opensimgear/device-gateway/electronics/boards/gateway/0.1.0/FOOTPRINTS.md

# Gateway footprint review

The local libraries travel with the KiCad project. Footprints are reviewed against drawings, not inferred from connector nicknames. Exact purchased samples and a fabricator slot/hole review are still required before ordering.

| Ref / part | Geometry and numbering checked | Source |
| --- | --- | --- |
| J2/J3 Evercom 5301-4P4C | Four actual contact positions; component-side drawing gives 1=(0,0), 2=(1.27,−2.54), 3=(2.54,0), 4=(3.81,−2.54) mm. Four Ø0.90 mm plated holes. Pegs (−1.91,6.35) and (5.59,6.35) mm, Ø3.20 mm unplated, 7.50 mm pitch. Body 11.10 ×18.05 ×11.45 mm; nose +Y14.25, rear −Y3.80. | Evercom 5301-440XXX Rev A, 2025-09-23, obtained from [C3097715](https://jlcpcb.com/partdetail/EVERCOM-53014P4C/C3097715); preserved at `.research/gateway-datasheets/evercom-5301.pdf`. |
| J5 Same Sky PJ-102AH | Pin 1 center positive at (0,0), pin 2 sleeve at (0,6), pin 3 switched sleeve at (4.7,3) mm; pin 3 intentionally NC. Current drawing calls for 1.0 ×1.6 mm slots; the local footprint uses 1.2 ×1.8 mm plated slots with allowance, oriented along X for pins 1/2 and Y for pin 3. Body/positions derive from the stock PJ-102AH footprint. Nose +Y13.7 mm. | [Manufacturer drawing](https://www.sameskydevices.com/product/resource/pj-102ah.pdf), 2024-09-12; `.research/gateway-datasheets/pj-102ah.pdf`. |
| F1 / F2 Littelfuse 1206L020/30YR / 1206L035/30WR | Manufacturer 1206L land pattern: two 1.8 ×1.8 mm lands with 1.0 mm gap. Both are 30 V rated. F1 0.20 A hold /0.42 A trip; F2 0.35 A hold /0.75 A trip, ratings at 20°C. | [Current 1206L data sheet](https://www.littelfuse.com/assetdocs/littelfuse-ptc-1206l-datasheet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); table extract at `.research/gateway-datasheets/littelfuse-1206l-excerpt.md`. |
| D6 SS14 / D7 SMBJ15A | Stock SMA / SMB lands; cathode pin 1, anode pin 2. D6 cathode is BUS_12V; D7 cathode BUS_12V, anode GND. | [SS14](https://www.vishay.com/docs/88746/ss12.pdf), [SMBJ](https://www.vishay.com/docs/88392/smbj.pdf). |
| U1, J1, U3, U4–U7 | Retained reviewed starter MCU, USB-C, SOIC transceiver, RECOM converter, LDO and manufacturer DCK0006A LM66100 geometry. Board USB routing retains the original stackup/width/gap. | MPN and manufacturer links in [BOM](bom.csv); local KiCad/OpenSimGear libraries. |

The native 4P4C footprint is `OpenSimGear.pretty/RJ4P4C_Evercom_5301-4P4C_Horizontal.kicad_mod`. Its pad numbers come from the component-side primary drawing; do not reverse them using a plug-view sketch. On this PCB both sockets rotate 90° clockwise in KiCad, with mouths facing the east edge. Actual board pad numbers remain 1 BUS_12V, 2 CAN_H, 3 CAN_L, 4 GND. Review the numbered native pads or a 1:1 plot when defining a cable tester.

To migrate another board, run `python3 tools/install-4p4c-footprint.py /absolute/path/to/its/revision` from the repository root to copy this footprint into its project-local OpenSimGear library, replace the socket symbol with four pins, explicitly reconnect all four net assignments, then update PCB placement and routing. A six-contact footprint cannot safely be changed by deleting its outer contacts: body, locating holes, stagger, pitch, numbering and electrical assignment differ. Regenerate the netlist, run schematic parity/ERC/DRC, and requalify purchased plugs and straight-through cable continuity. The separate module migration is outside this gateway revision.

The upstream footprint library license is retained in [LICENSE-KICAD.md](LICENSE-KICAD.md). The Evercom footprint is derived from KiCad's `RJ9_Evercom_5301-440xxx_Horizontal`, with the current 18.05 mm body depth, local MPN/description, reference on F.Fab and no unverified 3D model. Other unused copied library entries are not part of the BOM.
