opensimgear/device-gateway/electronics/boards/gateway/0.1.0/fabrication/drill/drill-report.txt

Drill report for gateway.kicad_pcb
Created on 2026-10-13T10:36:43

Copper Layer Stackup:
    =============================================================
    L1 :  F.Cu                      front
    L2 :  In1.Cu                    in1
    L3 :  In2.Cu                    in2
    L4 :  B.Cu                      back

Drill file 'gateway-PTH.drl' contains
    plated through holes:
    =============================================================
    T1  0.300mm  0.0118"  (93 holes))
    T2  0.600mm  0.0236"  (4 holes)  (with 4 slots)
    T3  0.900mm  0.0354"  (8 holes))
    T4  1.000mm  0.0394"  (3 holes))
    T5  1.020mm  0.0402"  (8 holes))
    T6  1.100mm  0.0433"  (4 holes))
    T7  1.200mm  0.0472"  (3 holes)  (with 3 slots)

    Total plated holes count 123

Drill file 'gateway-NPTH.drl' contains
    unplated through holes:
    =============================================================
    T1  0.650mm  0.0256"  (2 holes))
    T2  3.200mm  0.1260"  (8 holes))

    Total unplated holes count 10
