opensimgear/device-gateway/THIRD_PARTY_NOTICES.md

# Third-party materials

The repository's [all-rights-reserved notice](LICENSE) applies to original
OpenSimGear material. It does not relicense dependencies, third-party assets,
upstream library data or other separately licensed portions.

## Existing notices and provenance

- [Firmware notices](firmware/THIRD_PARTY.md) retain the TinyUSB, STM32 HAL,
  STM32 CMSIS and Arm CMSIS notices and dependency provenance.
- [libcanard](firmware/shared-cyphal/vendor/libcanard/LICENSE),
  [regulated DSDL](firmware/shared-cyphal/vendor/REGULATED_DSDL_LICENSE) and
  [Nunavut support](firmware/shared-cyphal/generated/NUNAVUT_LICENSE.rst)
  retain their upstream terms.
- [Included KiCad library data](electronics/boards/gateway/0.1.0/LICENSE-KICAD.md)
  retains the KiCad library license and exception, including where applicable
  to derived library entries.
- The Pico simulation uses separately licensed Pico SDK and TinyUSB sources;
  their notices remain with those sources and packaged firmware.

This file is a scope and provenance index, not a replacement for the full license
texts and copyright notices accompanying third-party material. Preserve the
applicable full notices when redistributing or packaging those portions. Existing
upstream permissions, including any commercial permissions, remain unaffected.
