opensimgear/device-gateway/electronics/boards/gateway/0.1.0/review/pcb.png

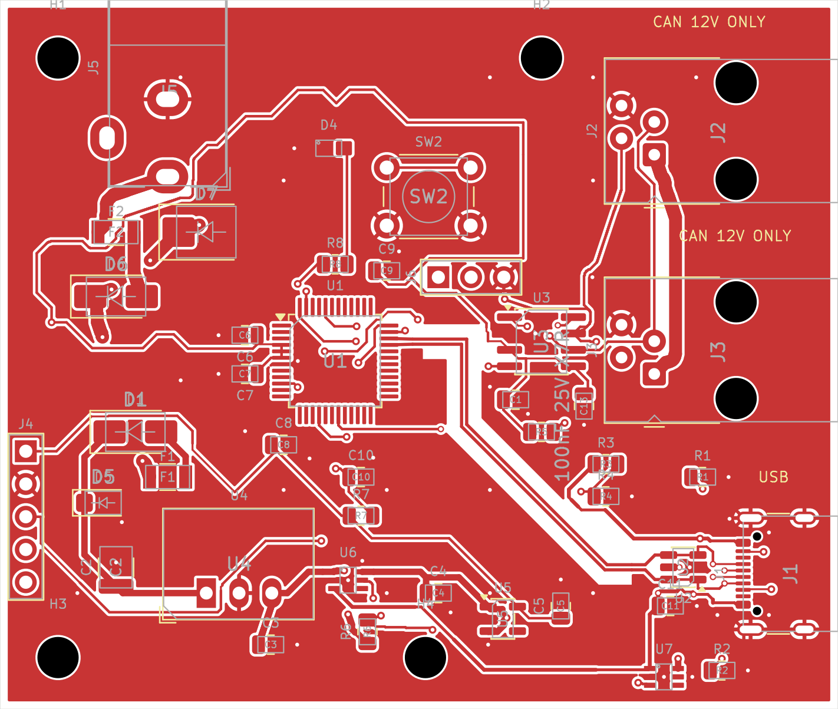
electronics/boards/gateway/0.1.0/review/pcb.png
