opensimgear/device-gateway/electronics/boards/gateway/0.1.0/bom.csv

Reference | Value | Manufacturer part | Footprint | Datasheet
C1 | 100nF 25V X7R | C0805C104K3RACTU | KiCad:C_0805_2012Metric | https://content.kemet.com/datasheets/KEM_C1002_X7R_SMD.pdf
C2 | 10uF 50V X7R | GRM32ER71H106KA12L | KiCad:C_1210_3225Metric | https://search.murata.co.jp/Ceramy/image/img/A01X/G101/ENG/GRM32ER71H106KA12-04A.pdf
C3 | 1uF 25V X7R | C2012X7R1E105K125AB | KiCad:C_0805_2012Metric | https://product.tdk.com/en/search/capacitor/ceramic/mlcc/info?part_no=C2012X7R1E105K125AB
C4 | 1uF 25V X7R | C2012X7R1E105K125AB | KiCad:C_0805_2012Metric | https://product.tdk.com/en/search/capacitor/ceramic/mlcc/info?part_no=C2012X7R1E105K125AB
C5 | 2.2uF 25V X7R | C2012X7R1E225K125AB | KiCad:C_0805_2012Metric | https://product.tdk.com/en/search/capacitor/ceramic/mlcc/info?part_no=C2012X7R1E225K125AB
C6 | 100nF 25V X7R | C0805C104K3RACTU | KiCad:C_0805_2012Metric | https://content.kemet.com/datasheets/KEM_C1002_X7R_SMD.pdf
C7 | 1uF 25V X7R | C2012X7R1E105K125AB | KiCad:C_0805_2012Metric | https://product.tdk.com/en/search/capacitor/ceramic/mlcc/info?part_no=C2012X7R1E105K125AB
C8 | 100nF 25V X7R | C0805C104K3RACTU | KiCad:C_0805_2012Metric | https://content.kemet.com/datasheets/KEM_C1002_X7R_SMD.pdf
C9 | 100nF 25V X7R | C0805C104K3RACTU | KiCad:C_0805_2012Metric | https://content.kemet.com/datasheets/KEM_C1002_X7R_SMD.pdf
C10 | 100nF 25V X7R | C0805C104K3RACTU | KiCad:C_0805_2012Metric | https://content.kemet.com/datasheets/KEM_C1002_X7R_SMD.pdf
C11 | 100nF 25V X7R | C0805C104K3RACTU | KiCad:C_0805_2012Metric | https://content.kemet.com/datasheets/KEM_C1002_X7R_SMD.pdf
C13 | 100nF 25V X7R | C0805C104K3RACTU | KiCad:C_0805_2012Metric | https://content.kemet.com/datasheets/KEM_C1002_X7R_SMD.pdf
D1 | SS14 | SS14-E3/61T | KiCad:D_SMA | https://www.vishay.com/docs/88746/ss12.pdf
D4 | GREEN | AP2012SGC | OpenSimGear:LED_Kingbright_AP2012SGC_0805 | https://www.kingbrightusa.com/images/catalog/SPEC/AP2012SGC.pdf
D5 | SMF15A-E3-08 | SMF15A-E3-08 | KiCad:D_SMF | https://www.vishay.com/docs/85881/smf5v0atosmf58a.pdf
D6 | SS14 | SS14-E3/61T | KiCad:D_SMA | https://www.vishay.com/docs/88746/ss12.pdf
D7 | SMBJ15A-E3/52 | SMBJ15A-E3/52 | KiCad:D_SMB | https://www.vishay.com/docs/88392/smbj.pdf
F1 | 0.20A hold / 30V | 1206L020/30YR | OpenSimGear:Fuse_Littelfuse_1206L020-30YR | https://www.littelfuse.com/assetdocs/littelfuse-ptc-1206l-datasheet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
F2 | 0.35A hold / 30V | 1206L035/30WR | OpenSimGear:Fuse_Littelfuse_1206L035-30WR | https://www.littelfuse.com/assetdocs/littelfuse-ptc-1206l-datasheet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
H1 | M3 3.2mm |  | KiCad:MountingHole_3.2mm_M3
H2 | M3 3.2mm |  | KiCad:MountingHole_3.2mm_M3
H3 | M3 3.2mm |  | KiCad:MountingHole_3.2mm_M3
H4 | M3 3.2mm |  | KiCad:MountingHole_3.2mm_M3
J1 | USB-C DEVICE | USB4105-GF-A | KiCad:USB_C_Receptacle_GCT_USB4105-xx-A_16P_TopMnt_Horizontal | https://gct.co/files/drawings/usb4105.pdf
J2 | 4P4C POWERED CAN | 5301-4P4C | OpenSimGear:RJ4P4C_Evercom_5301-4P4C_Horizontal | https://jlcpcb.com/partdetail/EVERCOM-53014P4C/C3097715
J3 | 4P4C POWERED CAN | 5301-4P4C | OpenSimGear:RJ4P4C_Evercom_5301-4P4C_Horizontal | https://jlcpcb.com/partdetail/EVERCOM-53014P4C/C3097715
J4 | SWD / 3V3 REFERENCE ONLY | TSW-105-07-L-S | OpenSimGear:PinHeader_Samtec_TSW-105-07-L-S_P2.54mm_Vertical | https://suddendocs.samtec.com/prints/tsw-xxx-xx-x-x-xx-xxx-footprint.pdf
J5 | 12V DC CENTER + / 5.5x2.1 | PJ-102AH | OpenSimGear:BarrelJack_SameSky_PJ-102AH_Horizontal | https://www.sameskydevices.com/product/resource/pj-102ah.pdf
J6 | CAN TEST / END TERMINATION | TSW-103-07-L-S | OpenSimGear:PinHeader_Samtec_TSW-103-07-L-S_P2.54mm_Vertical | https://suddendocs.samtec.com/prints/tsw-xxx-xx-x-x-xx-xxx-footprint.pdf
R1 | 5.1k 1% | RC0805FR-075K1L | KiCad:R_0805_2012Metric | https://www.yageogroup.com/component-documentation/download/specsheet/RC0805FR-075K1L
R2 | 5.1k 1% | RC0805FR-075K1L | KiCad:R_0805_2012Metric | https://www.yageogroup.com/component-documentation/download/specsheet/RC0805FR-075K1L
R3 | 10k 1% | RC0805FR-0710KL | KiCad:R_0805_2012Metric | https://www.yageogroup.com/component-documentation/download/specsheet/RC0805FR-0710KL
R4 | 15k 1% | RC0805FR-0715KL | KiCad:R_0805_2012Metric | https://www.yageogroup.com/component-documentation/download/specsheet/RC0805FR-0715KL
R5 | 10k | RC0805FR-0710KL | KiCad:R_0805_2012Metric | https://www.yageogroup.com/component-documentation/download/specsheet/RC0805FR-0710KL
R6 | 10k | RC0805FR-0710KL | KiCad:R_0805_2012Metric | https://www.yageo.com/upload/media/product/productsearch/datasheet/rchip/PYu-RC_Group_51_RoHS_L_13.pdf
R7 | 10k | RC0805FR-0710KL | KiCad:R_0805_2012Metric | https://www.yageogroup.com/component-documentation/download/specsheet/RC0805FR-0710KL
R8 | 1k | RC0805FR-071KL | KiCad:R_0805_2012Metric | https://www.yageogroup.com/component-documentation/download/specsheet/RC0805FR-071KL
SW2 | RESET | B3F-1002-G | KiCad:SW_PUSH_6mm_H4.3mm | https://omronfs.omron.com/en_US/ecb/products/pdf/en-b3f.pdf
U1 | STM32G0B1CBT6 | STM32G0B1CBT6 | KiCad:LQFP-48_7x7mm_P0.5mm | https://www.st.com/resource/en/datasheet/stm32g0b1cb.pdf
U2 | USBLC6-2SC6 | USBLC6-2SC6 | KiCad:SOT-23-6 | https://www.st.com/resource/en/datasheet/usblc6-2.pdf
U3 | TCAN3413D | TCAN3413D | KiCad:SOIC-8_3.9x4.9mm_P1.27mm | https://www.ti.com/lit/ds/symlink/tcan3413.pdf
U4 | R-78E5.0-0.5 | R-78E5.0-0.5 | KiCad:Converter_DCDC_RECOM_R-78E-0.5_THT | https://recom-power.com/pdf/Innoline/R-78E-0.5.pdf
U5 | TLV75533PDBVR | TLV75533PDBVR | KiCad:SOT-23-5 | https://www.ti.com/lit/ds/symlink/tlv755p.pdf
U6 | LM66100DCKR | LM66100DCKR | OpenSimGear:TI_DCK0006A_SC70-6_LM66100 | https://www.ti.com/lit/ds/symlink/lm66100.pdf
U7 | LM66100DCKR | LM66100DCKR | OpenSimGear:TI_DCK0006A_SC70-6_LM66100 | https://www.ti.com/lit/ds/symlink/lm66100.pdf
