opensimgear/device-gateway/tests/e2e/README.md

# Repository-owned end-to-end tests

## Development status and disclaimer

This project is heavily under development and is not ready for use. Use it entirely at your own risk. To the fullest extent permitted by applicable law, the authors and contributors disclaim all liability for any damage, loss, or other issues arising from its use.

See [the acceptance record](VERIFICATION.md) for the completed integration run.

Run from the repository root with Python 3.10+, Git and a C11 compiler:

```sh
python3 tests/e2e/run.py --sanitize
```

To clone and build Cockpit too (requires Node.js, pnpm and Rust/Tauri prerequisites):

```sh
python3 tests/e2e/run.py --sanitize --with-cockpit
```

The initiating repository owns the runner. It clones remote repositories listed in
`dependencies.json` into its ignored `.e2e/deps/`, initializes submodules recursively,
checks that both firmware repositories declare the same firmware-common commit,
and builds each runtime through that repository’s `simulation/build.py`.
The exact common pin is cloned automatically. Firmware refs are immutable commits
from the same contract milestone; update the device ref and both common pins
together so bootstrap cannot combine M3 firmware with M4 ownership callbacks. No parent setup or adjacent checkout
is consulted. Checkouts, builds, state and reports all stay under `.e2e/`.

`--prepare-only` provisions components without starting processes. The resulting
`.e2e/launch.json` names the binaries and owning source trees; `.e2e/resolved-dependencies.json`
records repository commits and any local working-tree snapshot hashes. Test evidence
is stored under `.e2e/runs/`. Remote application refs are intentionally `main` while
the project is work in progress; the resolved manifest records what a run actually used.

For unpublished cross-repository development, pass explicit source overrides:

```sh
python3 tests/e2e/run.py --sanitize --with-cockpit \
  --source device-template=/absolute/path/to/device-template \
  --source cockpit=/absolute/path/to/cockpit
```

An override still creates an isolated Git clone, applies the source’s tracked diff
and nonignored new files, and initializes its dependencies. It never modifies or
builds inside the source checkout. Clean submodule commit changes are initialized
after the snapshot is applied; uncommitted nested submodule contents are rejected
with a clear error. `.e2e/`, `.simulation/`, build outputs and other
ignored files are not copied. This is how coordinated changes can be tested before
they are published; default remote runs require those changes to exist on the
configured remote refs. A pinned firmware-common override uses the exact declared
commit, without local changes.

Only checkouts with a bootstrap receipt are replaced when sources change. Delete
this repository’s `.e2e/` to force clean provisioning. Run one bootstrap per repository
at a time. Bootstrap retry, executable-mode and submodule behavior can be checked
without network access using `python3 -m unittest discover -s tests/e2e -p 'test_*.py'`.

Each gateway acceptance run sets a fresh `OSG_SIMULATION_NAMESPACE` for its child
processes and records it in `result.json`. CDC discovery uses the corresponding
private `/tmp/opensimgear-<uid>/gateways-<name>/` directory, so an already running
desktop Cockpit cannot take the test gateway's single CDC connection after USB
layout detach/reconnect. The default simulator discovery path remains available
for ordinary development. Namespace/path bounds have separate native-runner tests.

The gateway scenario exercises three independent JSON devices, then a radio-panel process, through
real CDC and CAN transports, including device-before-gateway startup, profile changes,
saved configuration, automatic append and offline ghosts, generated HID layouts,
live and neutral reports, persistent Disable/Enable, offline Forget/rediscovery,
CDC-only empty state, save failure and restart recovery. Event checks capture a short press/release between polls, compare immutable retries with fresh pages, reject stale streams/boots and verify direct USB/disabled access without configuration or reconnect side effects. With `--with-cockpit`, the cloned Cockpit scenario also verifies its normal
discovery and configuration adapters against the gateway’s own build.

Native simulations execute the production configuration, flash journal, Cyphal
transport, registry and descriptor code. Loopback TCP carries CDC bytes and UDP
carries CAN frames. These tests validate protocol/report behavior; native streams
do not enumerate OS USB/HID devices. Physical USB/CAN acceptance remains separate.
