opensimgear/device-gateway/electronics/boards/gateway/0.1.0/review/schematic.pdf

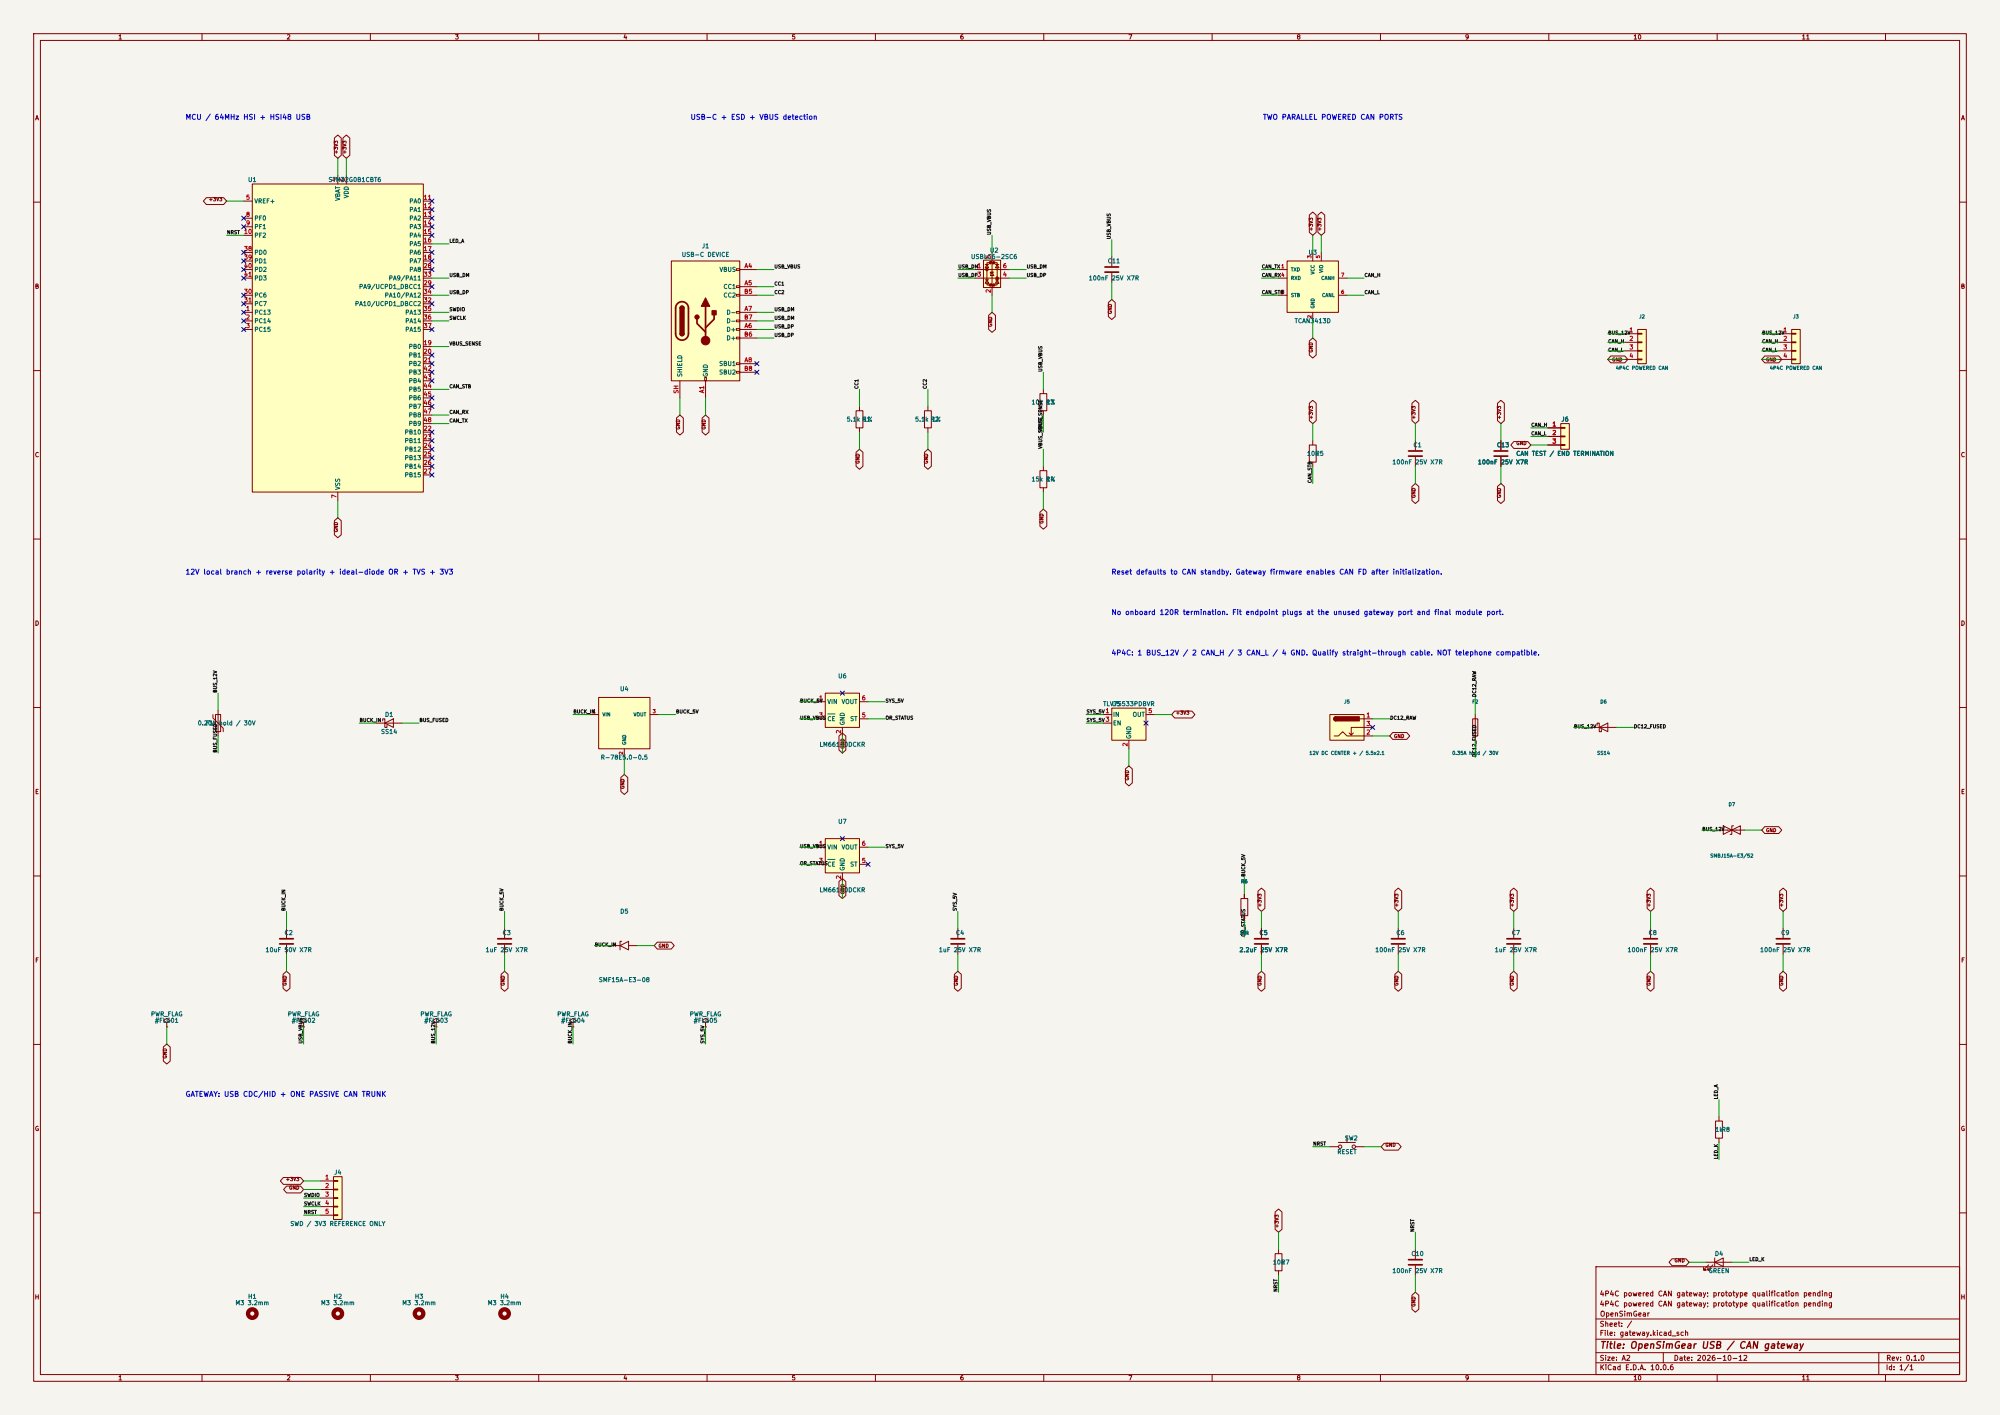
[picture p2: page 1]

4P4C powered CAN gateway; prototype qualification pending GND A1

J6 CAN TEST / END TERMINATION

12V local branch + reverse polarity + ideal-diode OR + TVS + 3V3

Reset defaults to CAN standby. Gateway firmware enables CAN FD after initialization.

No onboard 120R termination. Fit endpoint plugs at the unused gateway port and final module port.

4P4C: 1 BUS_12V / 2 CAN_H / 3 CAN_L / 4 GND. Qualify straight-through cable. NOT telephone compatible.

GATEWAY: USB CDC/HID + ONE PASSIVE CAN TRUNK

4P4C powered CAN gateway; prototype qualification pending
OpenSimGear
Sheet: /
File: gateway.kicad_sch
Title: OpenSimGear USB / CAN gateway

Size: A2 | Rev: 0.1.0
KiCad E.D.A. 10.0.6 | Id: 1/1
