opensimgear/device-gateway/electronics/boards/gateway/0.1.0/review/assembly.pdf

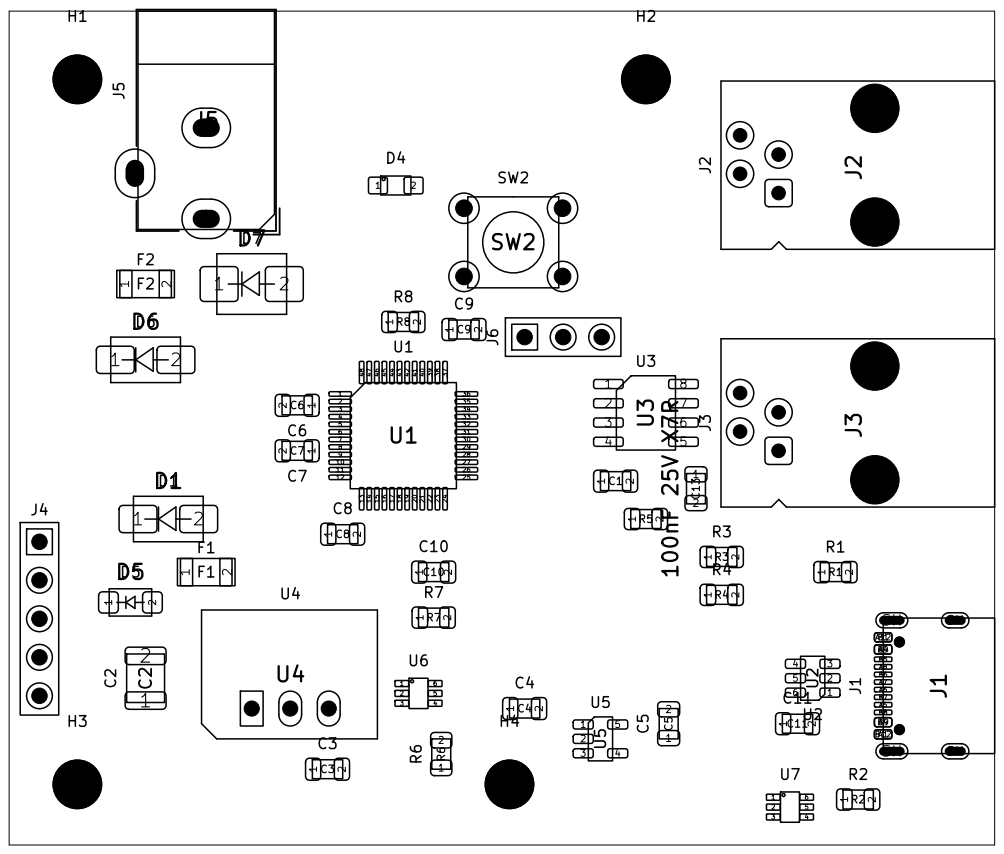
[picture p3: page 1]

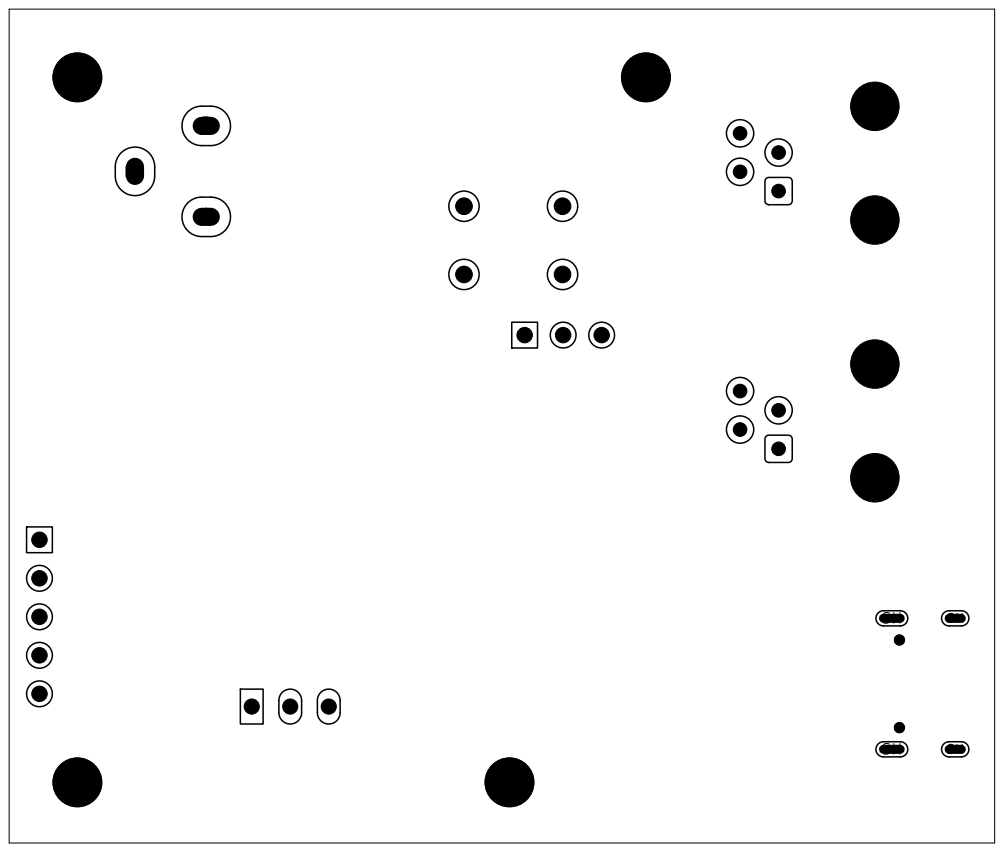
[picture p4: page 2]
