opensimgear/device-gateway/electronics/boards/gateway/0.1.0/gateway.kicad_pcb

## KiCad design electronics/boards/gateway/0.1.0/gateway.kicad_pcb (2026-10-13)

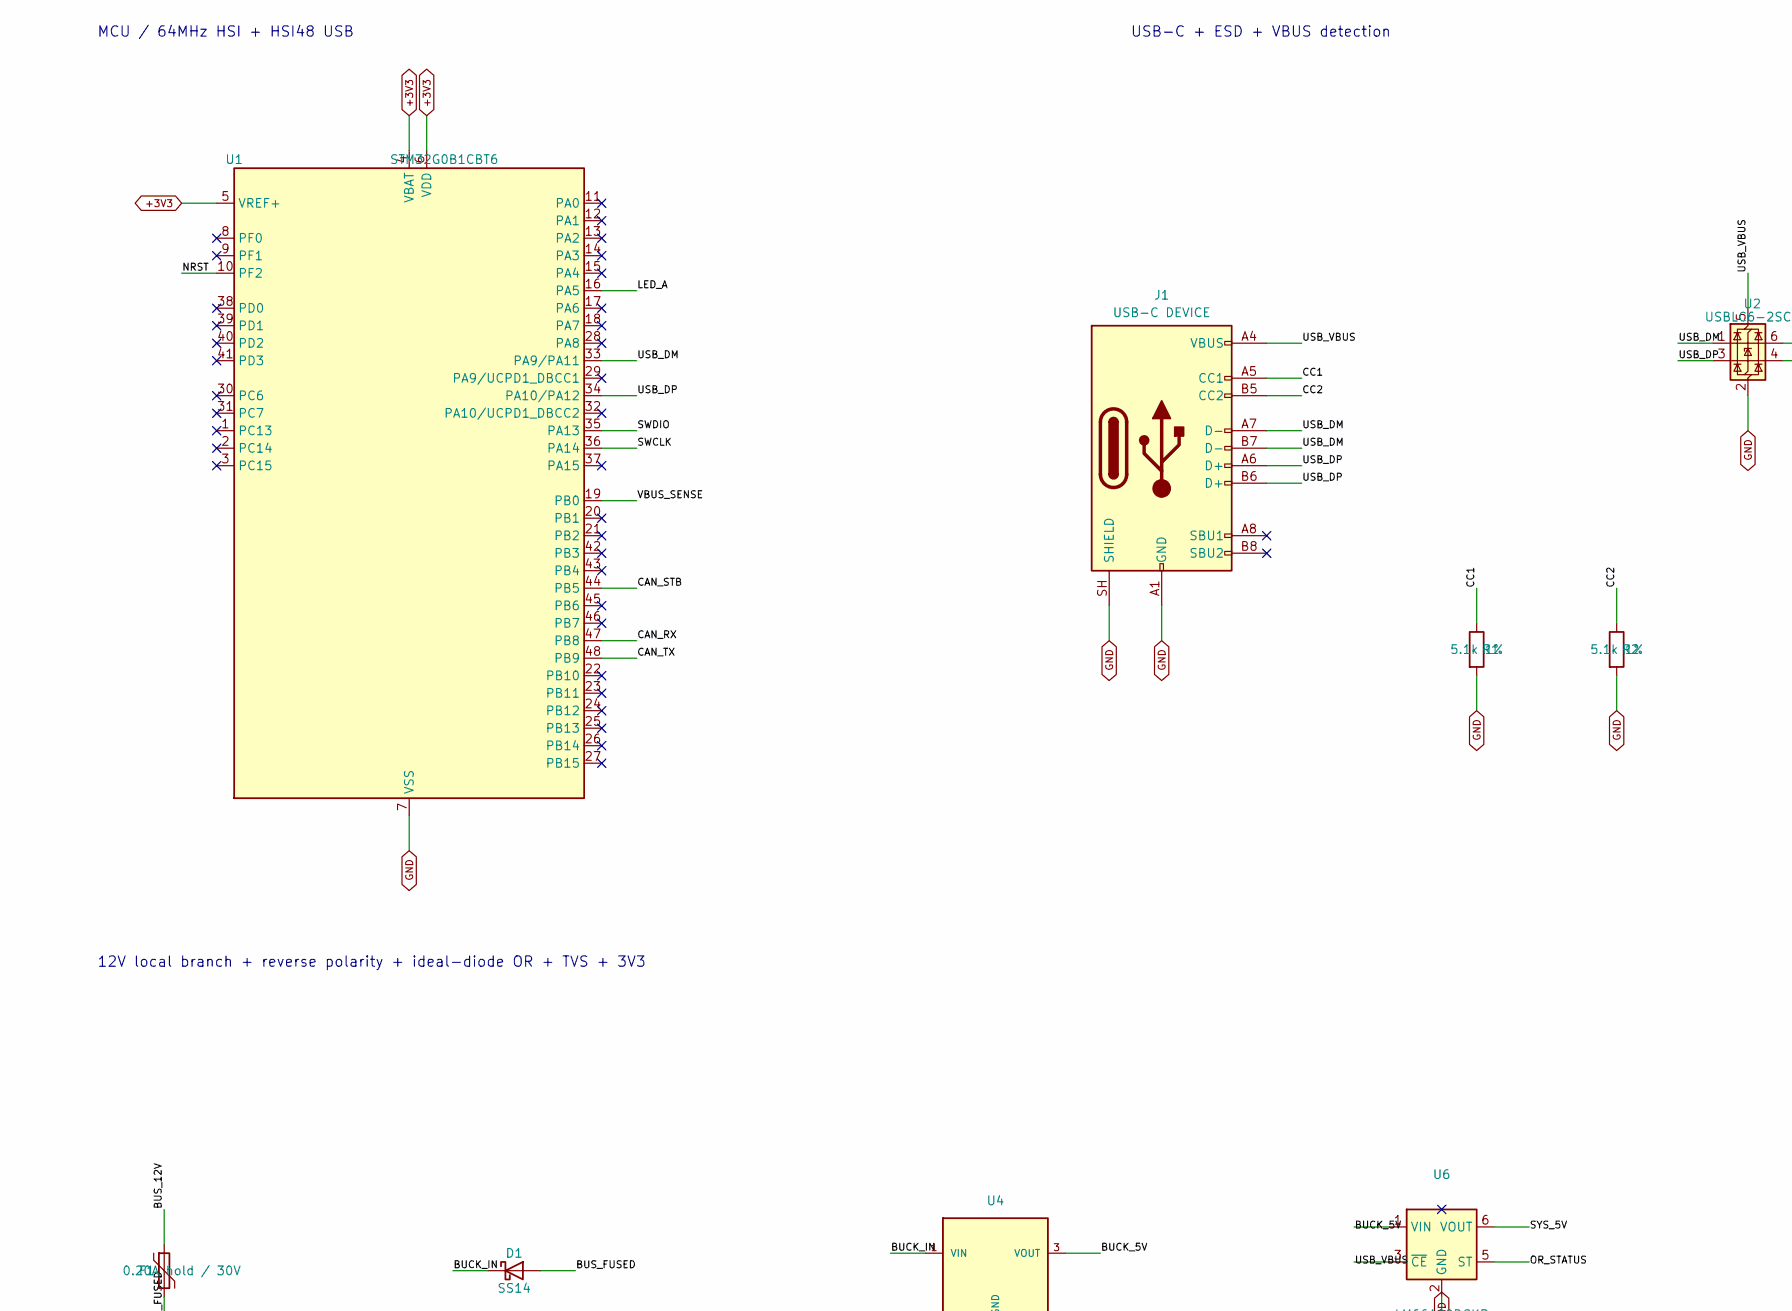
[picture p5: schematic gateway.kicad_sch, OpenSimGear USB / CAN gateway, part in row 1, column 1]

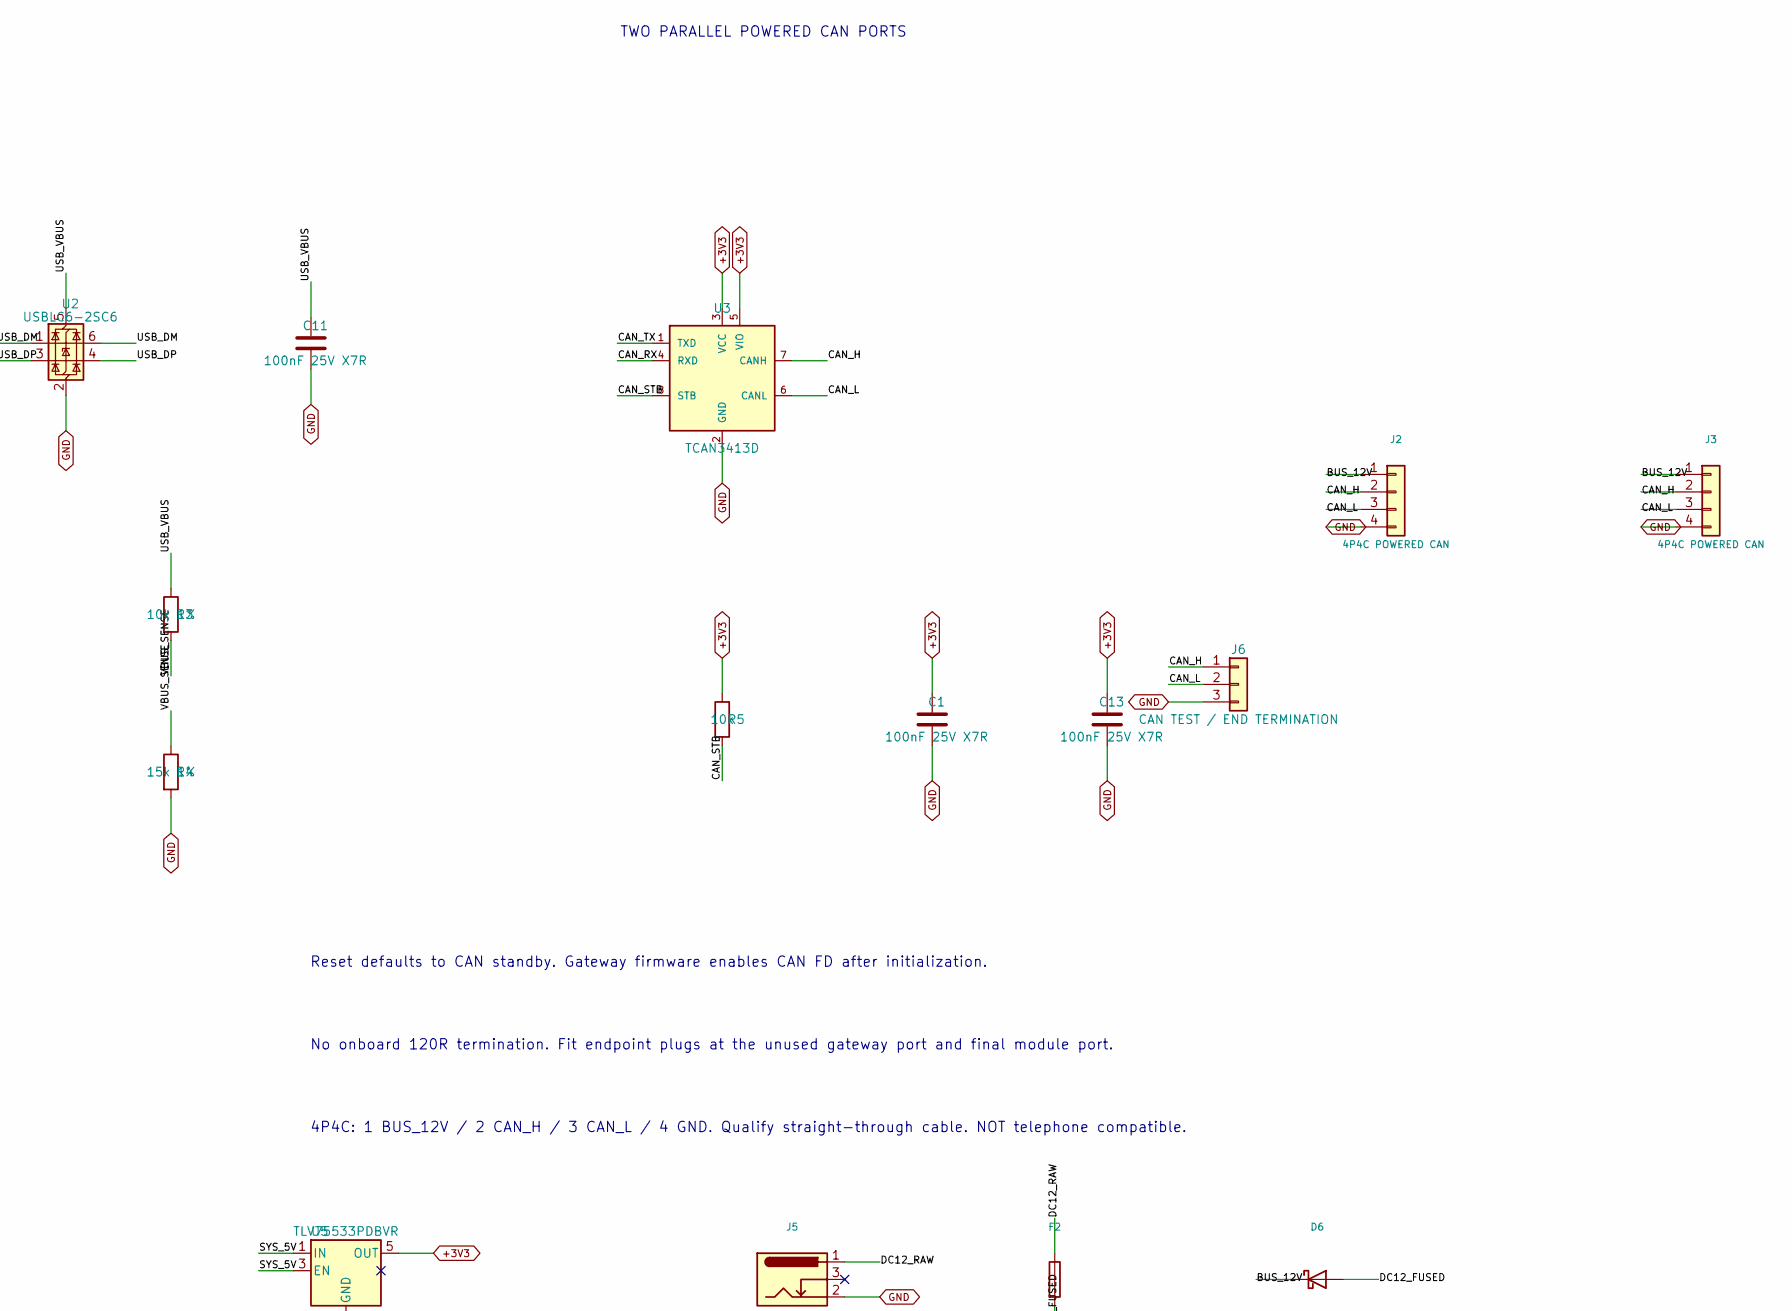
[picture p6: schematic gateway.kicad_sch, OpenSimGear USB / CAN gateway, part in row 1, column 2]

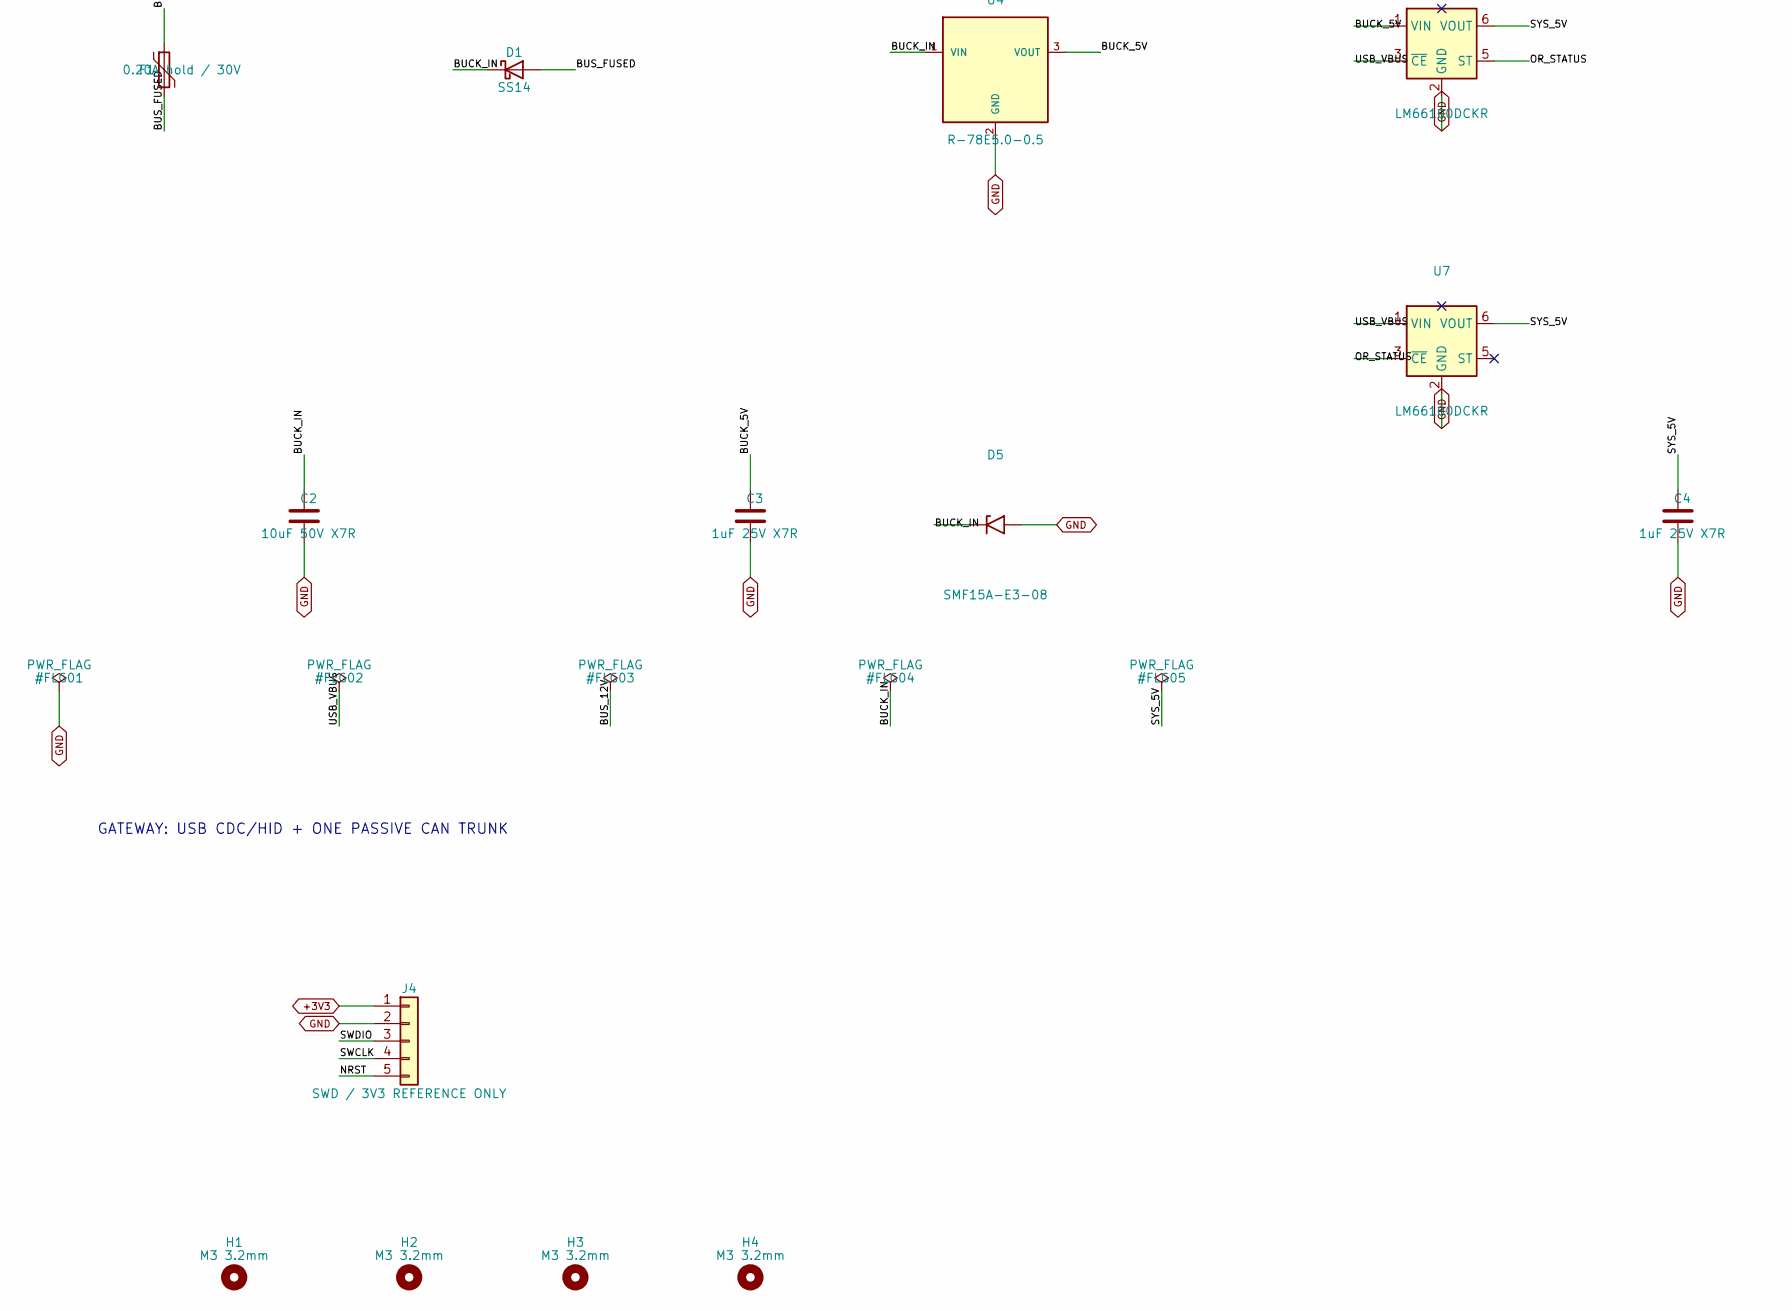
[picture p7: schematic gateway.kicad_sch, OpenSimGear USB / CAN gateway, part in row 2, column 1]

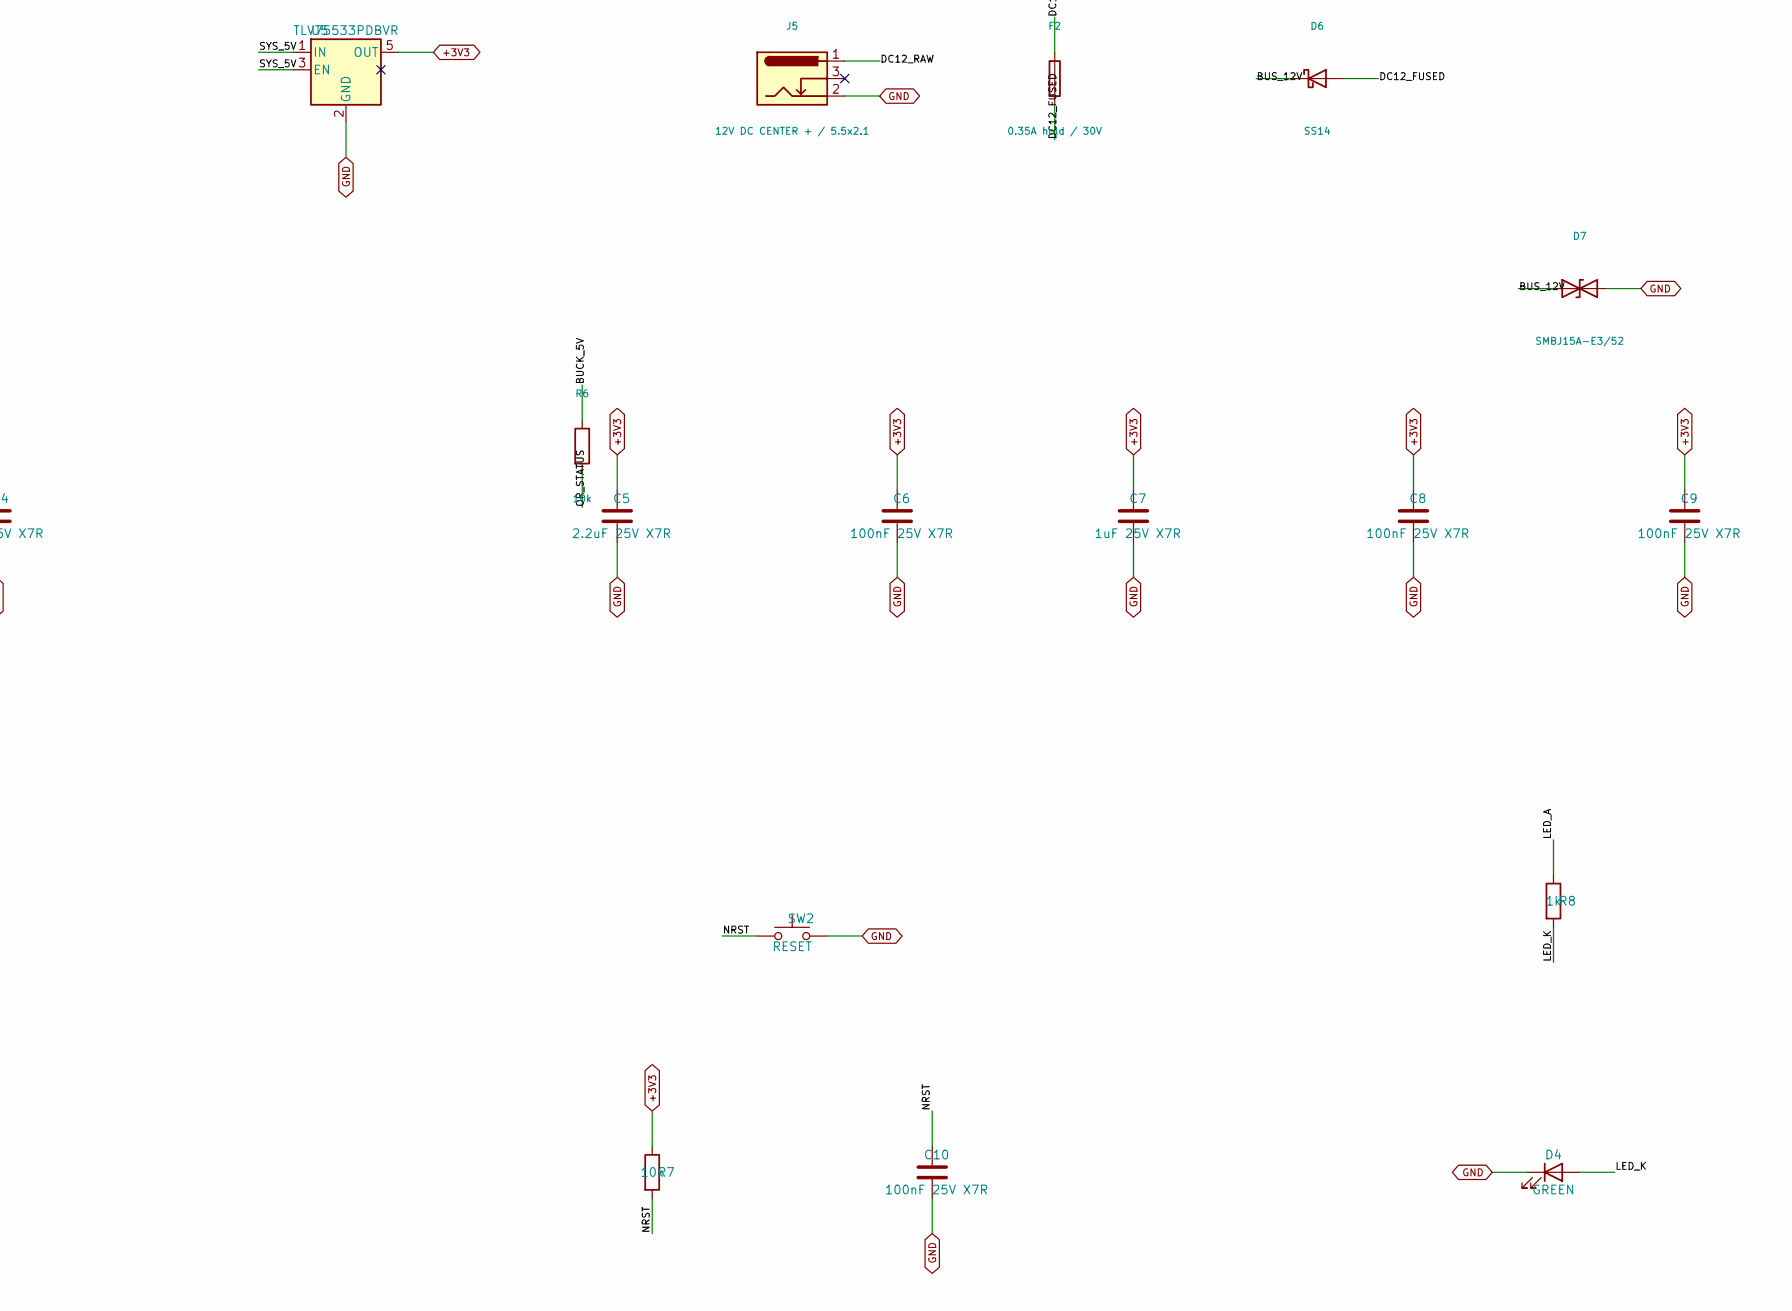
[picture p8: schematic gateway.kicad_sch, OpenSimGear USB / CAN gateway, part in row 2, column 2]

Parts:
C1, C6, C8, C9, C10, C11, C13: 100nF 25V X7R; C_0805_2012Metric; MPN C0805C104K3RACTU
C2: 10uF 50V X7R; C_1210_3225Metric; MPN GRM32ER71H106KA12L
C3, C4, C7: 1uF 25V X7R; C_0805_2012Metric; MPN C2012X7R1E105K125AB
C5: 2.2uF 25V X7R; C_0805_2012Metric; MPN C2012X7R1E225K125AB
D1, D6: SS14; D_SMA; MPN SS14-E3/61T
D4: GREEN; LED_Kingbright_AP2012SGC_0805; MPN AP2012SGC
D5: SMF15A-E3-08; D_SMF; MPN SMF15A-E3-08
D7: SMBJ15A-E3/52; D_SMB; MPN SMBJ15A-E3/52
F1: 0.20A hold / 30V; Fuse_Littelfuse_1206L020-30YR; MPN 1206L020/30YR
F2: 0.35A hold / 30V; Fuse_Littelfuse_1206L035-30WR; MPN 1206L035/30WR
H1, H2, H3, H4: M3 3.2mm; MountingHole_3.2mm_M3
J1: USB-C DEVICE; USB_C_Receptacle_GCT_USB4105-xx-A_16P_TopMnt_Horizontal; MPN USB4105-GF-A
J2, J3: 4P4C POWERED CAN; RJ4P4C_Evercom_5301-4P4C_Horizontal; MPN 5301-4P4C
J4: SWD / 3V3 REFERENCE ONLY; PinHeader_Samtec_TSW-105-07-L-S_P2.54mm_Vertical; MPN TSW-105-07-L-S
J5: 12V DC CENTER + / 5.5x2.1; BarrelJack_SameSky_PJ-102AH_Horizontal; MPN PJ-102AH
J6: CAN TEST / END TERMINATION; PinHeader_Samtec_TSW-103-07-L-S_P2.54mm_Vertical; MPN TSW-103-07-L-S
R1, R2: 5.1k 1%; R_0805_2012Metric; MPN RC0805FR-075K1L
R3: 10k 1%; R_0805_2012Metric; MPN RC0805FR-0710KL
R4: 15k 1%; R_0805_2012Metric; MPN RC0805FR-0715KL
R5, R6, R7: 10k; R_0805_2012Metric; MPN RC0805FR-0710KL
R8: 1k; R_0805_2012Metric; MPN RC0805FR-071KL
SW2: RESET; SW_PUSH_6mm_H4.3mm; MPN B3F-1002-G
U1: STM32G0B1CBT6; LQFP-48_7x7mm_P0.5mm; MPN STM32G0B1CBT6
U2: USBLC6-2SC6; SOT-23-6; MPN USBLC6-2SC6
U3: TCAN3413D; SOIC-8_3.9x4.9mm_P1.27mm; MPN TCAN3413D
U4: R-78E5.0-0.5; Converter_DCDC_RECOM_R-78E-0.5_THT; MPN R-78E5.0-0.5
U5: TLV75533PDBVR; SOT-23-5; MPN TLV75533PDBVR
U6, U7: LM66100DCKR; TI_DCK0006A_SC70-6_LM66100; MPN LM66100DCKR

Connections:
+3V3: C1.1, C5.1, C6.1, C7.1, C8.1, C9.1, C13.1, J4.1, R5.1, R7.1, U1.4 (VBAT), U1.5 (VREF+), U1.6 (VDD), U3.3 (VCC), U3.5 (VIO), U5.5 (OUT)
/BUCK_5V: C3.1, R6.1, U4.3 (VOUT), U6.1 (VIN)
/BUCK_IN: C2.1, D1.1 (K), D5.1 (A1), U4.1 (VIN)
/BUS_12V: D6.1 (K), D7.1 (A1), F1.1, J2.1, J3.1
/BUS_FUSED: D1.2 (A), F1.2
/CAN_H: J2.2, J3.2, J6.1, U3.7 (CANH)
/CAN_L: J2.3, J3.3, J6.2, U3.6 (CANL)
/CAN_RX: U1.47 (PB8), U3.4 (RXD)
/CAN_STB: R5.2, U1.44 (PB5), U3.8 (STB)
/CAN_TX: U1.48 (PB9), U3.1 (TXD)
/CC1: J1.A5 (CC1), R1.1
/CC2: J1.B5 (CC2), R2.1
/DC12_FUSED: D6.2 (A), F2.2
/DC12_RAW: F2.1, J5.1
/LED_A: R8.1, U1.16 (PA5)
/LED_K: D4.2 (A), R8.2
/NRST: C10.1, J4.5, R7.2, SW2.1, U1.10 (PF2)
/OR_STATUS: R6.2, U6.5 (ST), U7.3 (~CE)
/SWCLK: J4.4, U1.36 (PA14)
/SWDIO: J4.3, U1.35 (PA13)
/SYS_5V: C4.1, U5.1 (IN), U5.3 (EN), U6.6 (VOUT), U7.6 (VOUT)
/USB_DM: J1.A7 (D-), J1.B7 (D-), U1.33 (PA9/PA11), U2.1 (I/O1), U2.6 (I/O1)
/USB_DP: J1.A6 (D+), J1.B6 (D+), U1.34 (PA10/PA12), U2.3 (I/O2), U2.4 (I/O2)
/USB_VBUS: C11.1, J1.A4 (VBUS), J1.A9 (VBUS), J1.B4 (VBUS), J1.B9 (VBUS), R3.1, U2.5 (VBUS), U6.3 (~CE), U7.1 (VIN)
/VBUS_SENSE: R3.2, R4.1, U1.19 (PB0)
GND: C1.2, C2.2, C3.2, C4.2, C5.2, C6.2, C7.2, C8.2, C9.2, C10.2, C11.2, C13.2, D4.1 (K), D5.2 (A2), D7.2 (A2), J1.A1 (GND), J1.A12 (GND), J1.B1 (GND), J1.B12 (GND), J1.SH (SHIELD), J2.4, J3.4, J4.2, J5.2, J6.3, R1.2, R2.2, R4.2, SW2.2, U1.7 (VSS), U2.2 (GND), U3.2 (GND), U4.2 (GND), U5.2 (GND), U6.2 (GND), U7.2 (GND)

Notes on the sheet:
12V local branch + reverse polarity + ideal-diode OR + TVS + 3V3
No onboard 120R termination. Fit endpoint plugs at the unused gateway port and final module port.
MCU / 64MHz HSI + HSI48 USB
TWO PARALLEL POWERED CAN PORTS
4P4C: 1 BUS_12V / 2 CAN_H / 3 CAN_L / 4 GND. Qualify straight-through cable. NOT telephone compatible.
Reset defaults to CAN standby. Gateway firmware enables CAN FD after initialization.
USB-C + ESD + VBUS detection
GATEWAY: USB CDC/HID + ONE PASSIVE CAN TRUNK

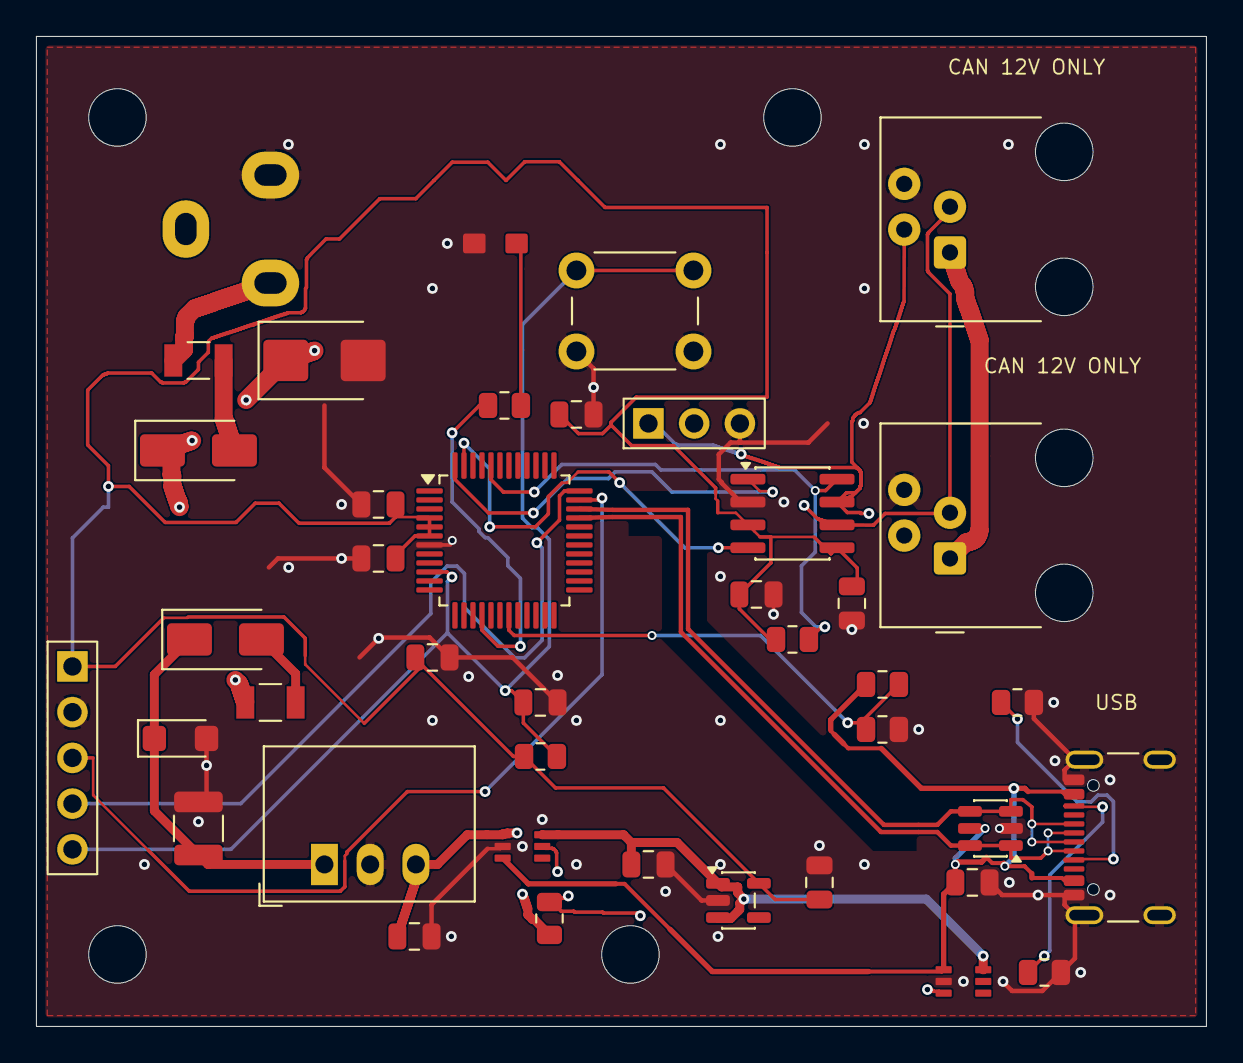
[picture p9: board gateway.kicad_pcb from above]

Board: 4 copper layers, 65.0 x 55.0 mm, 45 parts (0 on the bottom side), 26 nets.
