opensimgear/device-gateway/(commit log)

2026-10-11 Rename device template references and clarify starter scope
2026-10-12 Add two-port gateway firmware and Rev A PCB prototype
    [bom.csv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]
2026-10-12 chore: rename gateway project to device-gateway
2026-10-12 docs: describe current gateway implementation and validation
2026-10-12 Use shared Cyphal transport and test discovery and reboot recovery in CI
    [board.c, board.h, can_peer.py, cyphal_peer_bridge.c, gateway.c, gateway.h, gateway_cockpit.c]
2026-10-13 Consolidate gateway PCB as pre-live version 0.1.0
    [bom.csv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]
2026-10-13 Add JLCPCB fabrication and assembly export tooling
2026-10-13 Automatically enroll ordered HID controllers and remember disabled devices
2026-10-13 Route device actions through guarded CAN sessions and isolated simulations
2026-10-14 Align M4 integration pins and install Pico C++ support
2026-10-14 Clarify Pico compatibility test loop for GCC warnings
2026-10-14 Clarify Pico input and output-only preset capacities
2026-10-17 Pin the matching module and common source for gateway acceptance
2026-11-05 Emit sequenced CAN publication invalidations [skip ci]
    [gateway.c, gateway_cockpit.c, gateway_publication.c, main.c, test_gateway.py]
2026-11-05 Stream CAN admission warnings without invalidating ownership [skip ci]
    [gateway_publication.c]
2026-11-05 Publish sequenced Pico Debug inventory changes [skip ci]
    [debug_gateway.c, debug_gateway.h, main.c]
2026-11-05 Separate Pico Debug watchdog renewal from inventory reads [skip ci]
    [debug_gateway.c]
